mpuugaAbdu/Smart-movable-Dustbin/report.docx

# SMART VOICE CONTROLLED DUSTBIN

# CHAPTER ONE

# INTRODUCTION

## 1.0 Introduction

The advancement of technology has significantly transformed healthcare delivery by introducing intelligent systems that improve efficiency, safety, and convenience in medical environments. Automation, robotics, and artificial intelligence (AI) have become increasingly important in modern healthcare, particularly in reducing manual operations and supporting healthcare professionals during critical procedures.

Surgical theatres are highly sensitive environments where medical personnel must maintain strict hygiene standards, minimize unnecessary movements, and concentrate on patient care. During surgical operations, healthcare professionals generate different types of medical waste, including used gauze, gloves, packaging materials, and other disposable medical supplies. Proper disposal of these materials is essential for maintaining cleanliness and reducing the risk of contamination.

Conventional waste bins are generally positioned at fixed locations within operating theatres. Consequently, medical personnel may need to move toward a waste disposal point or depend on an assistant to bring a waste container closer. Such activities may introduce unnecessary movements and interruptions during surgical procedures.

This project presents the design and development of an offline voice-controlled mobile smart dustbin for surgical theatres, utilizing the AI-Thinker VC-02 offline voice recognition module. The proposed system allows authorized medical personnel to issue predefined voice commands that activate the dustbin's movement, enabling it to approach a designated location for convenient waste disposal.

Unlike conventional voice-controlled systems that depend on internet connectivity or cloud-based speech processing, the proposed system operates offline. This makes it potentially suitable for environments where reliable internet access may not always be available.

The project aims to demonstrate how embedded systems, offline voice recognition, and mobile robotics can be integrated to develop an intelligent waste disposal assistant that supports medical personnel during surgical operations.

## 1.1 Background of the Study

Healthcare facilities continuously seek technological solutions that enhance service delivery, improve operational efficiency, and maintain high standards of hygiene. One area where technological innovation can provide practical assistance is medical waste management.

Medical waste is generated during healthcare activities such as diagnosis, treatment, surgery, and laboratory procedures. In surgical theatres, waste management requires particular attention because of the need to maintain a controlled and hygienic working environment.

Traditionally, waste disposal involves placing waste materials into designated containers positioned at specific locations within the theatre. Although this approach is widely used, it may require healthcare professionals to move away from their immediate working positions or request assistance from other personnel.

Advancements in embedded systems and robotics have created opportunities to automate routine activities. Mobile robotic systems can perform tasks such as transporting materials, delivering supplies, and assisting with logistical operations in healthcare facilities.

Similarly, voice recognition technology enables users to interact with electronic systems through spoken commands. This provides a hands-free control method, which can be beneficial in environments where manual interaction with equipment is inconvenient or undesirable.

The AI-Thinker VC-02 module is an offline voice recognition device capable of recognizing configured voice commands without requiring continuous internet connectivity. When integrated with a microcontroller, motor-driving circuitry, and a mobile platform, the module can serve as a voice-based control interface for a robotic dustbin.

The proposed smart dustbin combines offline voice recognition with robotic mobility to create a system that responds to spoken instructions from medical personnel. For example, a surgeon or theatre assistant could issue a predefined command requesting the dustbin to approach a designated disposal position.

By reducing the need for personnel to move toward a stationary waste container, the system seeks to improve convenience and support smoother workflows within surgical environments.

However, successful application in an actual surgical theatre would require additional considerations, including infection prevention, safe navigation, obstacle detection, appropriate waste containment, and compliance with healthcare safety requirements.

## 1.2 Problem Statement

Surgical operations require healthcare professionals to maintain concentration, minimize unnecessary movements, and follow strict infection prevention procedures. However, conventional waste disposal systems often rely on stationary dustbins, requiring medical personnel to move toward waste collection points or request assistance when disposing of materials.

These manual activities may interrupt workflow, increase unnecessary movement within the operating theatre, and reduce convenience during surgical procedures.

Although automated systems are increasingly being introduced into healthcare environments, many conventional waste bins lack intelligent features such as voice interaction and autonomous or remotely controlled mobility.

Furthermore, some voice-controlled systems depend on internet connectivity, which can limit their reliability in environments with unstable network access.

There is therefore a need to investigate a hands-free, offline voice-controlled mobile waste disposal system that can assist medical personnel by bringing a waste container closer to a designated point when requested.

This project addresses the problem through the development of a prototype smart dustbin using the AI-Thinker VC-02 offline voice recognition module and an embedded motor control system. The proposed solution is intended to demonstrate a convenient approach to waste disposal assistance while minimizing the need for direct physical interaction with the dustbin.

## 1.3 Main Objective

To design and develop an offline voice-controlled mobile smart dustbin that responds to predefined spoken commands and assists medical personnel with convenient waste disposal during surgical procedures.

## 1.4 Specific Objectives

The specific objectives of this project are:

1. To design a mobile smart dustbin capable of responding to predefined voice commands using the AI-Thinker VC-02 offline voice recognition module.
2. To develop an embedded control system that interprets recognized voice commands and controls the movement of the dustbin.
3. To integrate the voice recognition module, microcontroller, motor driver, motors, and power supply into a functional mobile robotic platform.
4. To implement and evaluate hands-free voice control of the dustbin under different operating conditions.
5. To assess the prototype's response time, command recognition reliability, mobility, and potential suitability for assisting waste disposal activities in surgical environments.

## 1.5 Research Questions

This project seeks to answer the following research questions:

1. How can offline voice recognition technology be integrated into a mobile smart dustbin?
2. How effectively can the AI-Thinker VC-02 module recognize predefined voice commands in different environmental conditions?
3. How can a microcontroller-based system control the movement of a dustbin in response to recognized voice commands?
4. What is the response time and reliability of the developed voice-controlled mobile dustbin?
5. To what extent could a voice-controlled mobile dustbin improve convenience and reduce unnecessary movement during surgical waste disposal?

## 1.6 Significance of the Study

The development of an offline voice-controlled mobile smart dustbin has potential benefits in healthcare, engineering education, and technological innovation.

1. Improved convenience for medical personnel

The system is intended to allow healthcare professionals to request a waste container using voice commands instead of physically moving toward a stationary dustbin. This could make routine waste disposal more convenient during surgical procedures.

2. Support for hands-free interaction

Voice recognition provides a method of controlling the dustbin without touching its control interface. This could help reduce unnecessary contact with equipment, although it does not eliminate the need to follow established infection prevention procedures.

3. Reduced dependence on internet connectivity

By using the AI-Thinker VC-02 offline voice recognition module, the system can process configured voice commands without requiring cloud services or continuous internet access.

4. Promotion of healthcare automation

The project demonstrates the potential application of embedded systems, robotics, and voice recognition technology in addressing practical challenges within healthcare environments.

5. Contribution to engineering research and education

The project provides a practical example of integrating voice recognition, microcontroller programming, motor control, and robotic system design. It can serve as a reference for students and researchers developing similar assistive technologies.

6. Potential for further innovation

The prototype could provide a foundation for future developments incorporating obstacle avoidance, intelligent navigation, automatic waste-bin opening, docking systems, and improved safety mechanisms.

## 1.7 Scope of the Study

The scope of this project covers the design, development, integration, and preliminary testing of an offline voice-controlled mobile smart dustbin intended for surgical theatre assistance.

### 1.7.1 Technical Scope

The project focuses on the following areas:

- Implementation of offline voice command recognition using the AI-Thinker VC-02 module.
- Development of a microcontroller-based control system.
- Integration of motors and motor-driving circuitry to enable dustbin movement.
- Development of a mobile platform capable of carrying a waste container.
- Integration of an appropriate power supply for the electronic and electromechanical components.
- Testing of voice command recognition, motor response, and movement control.

### 1.7.2 Functional Scope

The system is intended to recognize predefined voice commands and translate them into appropriate movement instructions.

Its primary function is to enable a user to request or control the movement of the dustbin through spoken instructions.

The level of navigation autonomy depends on the implemented hardware and software. Features such as automatic user localization, obstacle avoidance, and autonomous return to a docking station are not assumed to be present unless separately implemented.

### 1.7.3 Application Scope

The project is primarily intended as a prototype for exploring voice-controlled waste disposal assistance in surgical theatre environments.

Initial testing will focus on demonstrating system functionality under controlled conditions rather than direct deployment during live surgical operations.

Actual clinical deployment would require further evaluation of infection prevention, electrical and mechanical safety, navigation reliability, medical waste segregation, and applicable hospital requirements.

## 1.8 Limitations of the Study

Despite its potential advantages, the proposed system may face several limitations.

1. Background noise

Surgical environments contain equipment and conversations that may interfere with voice command recognition. The performance of the VC-02 module may therefore vary depending on surrounding noise levels.

2. Limited voice command vocabulary

The system relies on predefined commands supported by the offline voice recognition module. It may not understand spoken instructions outside the configured command set.

3. Navigation challenges

The movement of the dustbin may be affected by obstacles, restricted pathways, uneven surfaces, and limited operating space. Without appropriate sensing and navigation features, the system may require controlled operating conditions.

4. Power supply limitations

Because the dustbin is mobile, its operation depends on an onboard power source. Battery capacity and motor power consumption may limit its operating duration.

5. Clinical safety considerations

A mobile robotic dustbin operating near surgical personnel must not interfere with medical equipment, sterile zones, or movement around the patient. Additional safeguards and validation would be required before use in actual operating theatres.

6. Waste handling requirements

Medical waste may contain infectious, sharp, or otherwise hazardous materials. The prototype does not automatically establish compliance with medical waste segregation and disposal standards. Appropriate containment and cleaning procedures would be necessary.

## 1.9 Justification of the Study

The development of an offline voice-controlled mobile smart dustbin is motivated by the need to explore practical technological solutions that can support healthcare professionals during demanding medical procedures.

In surgical theatres, unnecessary movement and interruptions can affect the efficiency of routine activities. A mobile dustbin that responds to spoken commands offers a potentially convenient alternative to conventional stationary waste containers.

The use of offline voice recognition is particularly relevant because it allows the system to function without depending on internet connectivity. This approach may also reduce the complexity associated with cloud-based voice processing.

Additionally, the project demonstrates how relatively accessible electronic components and embedded technologies can be combined to address real-world healthcare challenges.

The study is therefore justified as a prototype development effort that investigates the technical feasibility of voice-controlled mobile waste disposal assistance and establishes a foundation for future improvements and clinical evaluation.

## 1.10 Organization of the Report

This report is organized into five chapters.

Chapter One: Introduction

This chapter presents the background of the study, problem statement, objectives, research questions, significance, scope, limitations, and justification of the project.

Chapter Two: Literature Review

This chapter reviews existing studies and technologies related to smart waste management, healthcare robotics, offline voice recognition, embedded control systems, and mobile robotic platforms.

Chapter Three: Methodology and System Design

This chapter describes the research methodology, hardware components, system architecture, circuit design, software development, and procedures followed during implementation.

Chapter Four: System Implementation, Testing, and Results

This chapter presents the implementation of the developed prototype, testing procedures, observations, performance measurements, and discussion of results.

Chapter Five: Conclusion and Recommendations

This chapter summarizes the project findings, evaluates the achievement of the objectives, identifies remaining challenges, and provides recommendations for future improvements.
