mpuugaAbdu/Smart-movable-Dustbin/images/control details edit.png

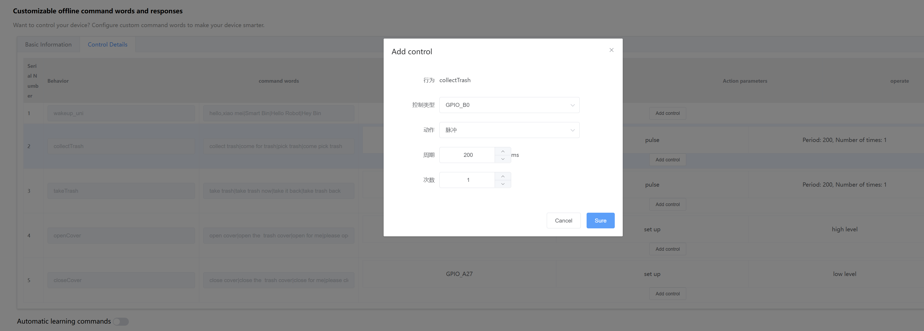
images/control details edit.png
