mpuugaAbdu/Smart-movable-Dustbin/images/perfB.png

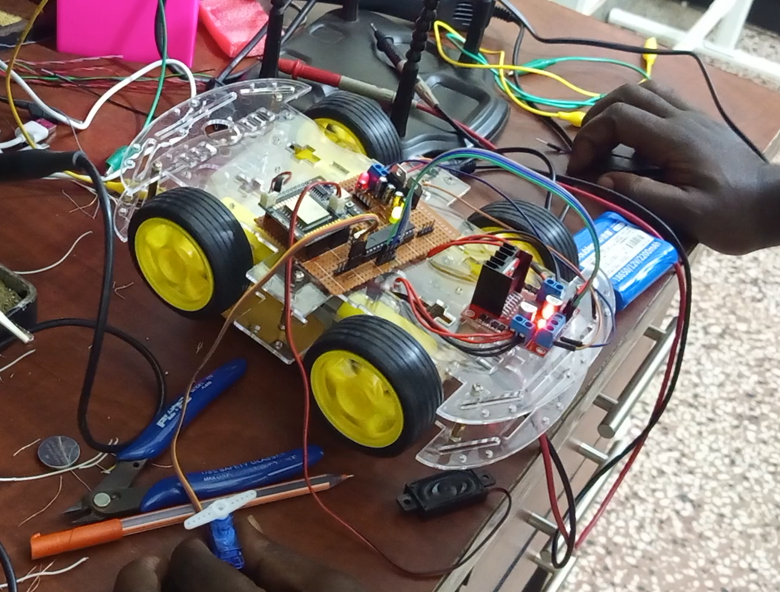
images/perfB.png
