mpuugaAbdu/Smart-movable-Dustbin/images/pin config.png

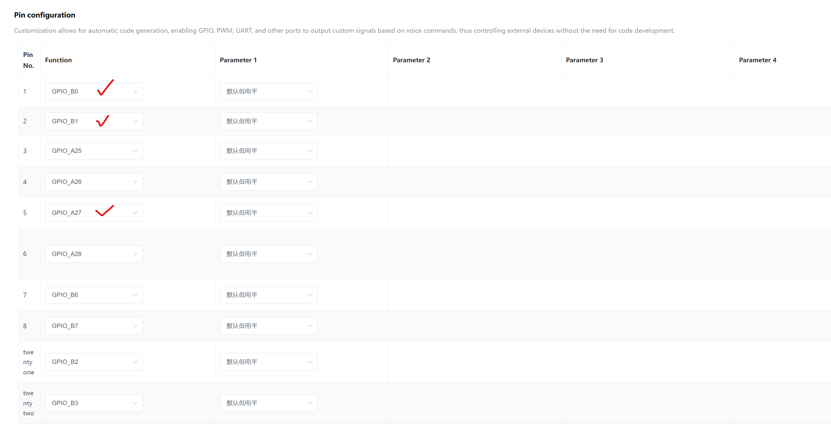
images/pin config.png
