mpuugaAbdu/Smart-movable-Dustbin/images/sdk download.png

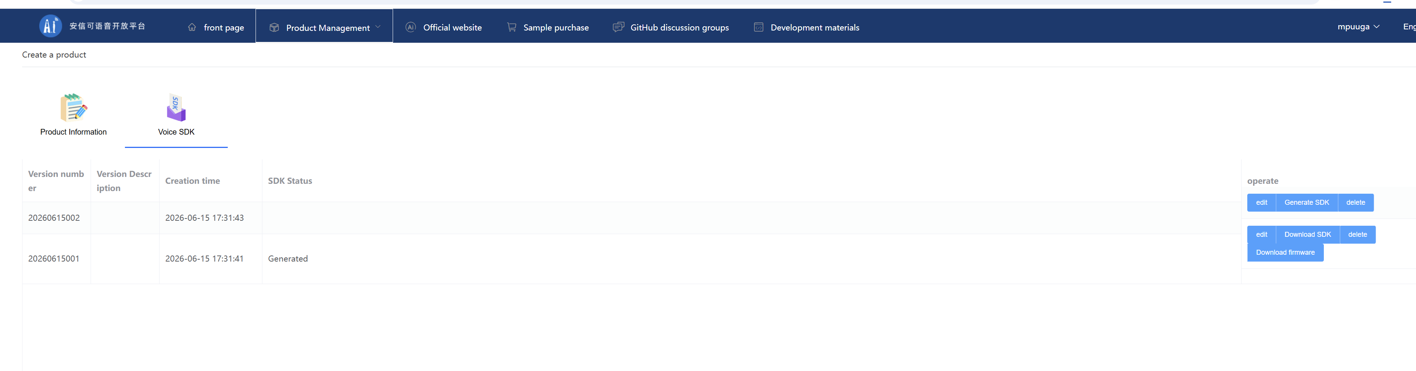
images/sdk download.png
