mpuugaAbdu/Smart-movable-Dustbin/stl files for control circuit casing/robotic_ctrl-PartBody.stl

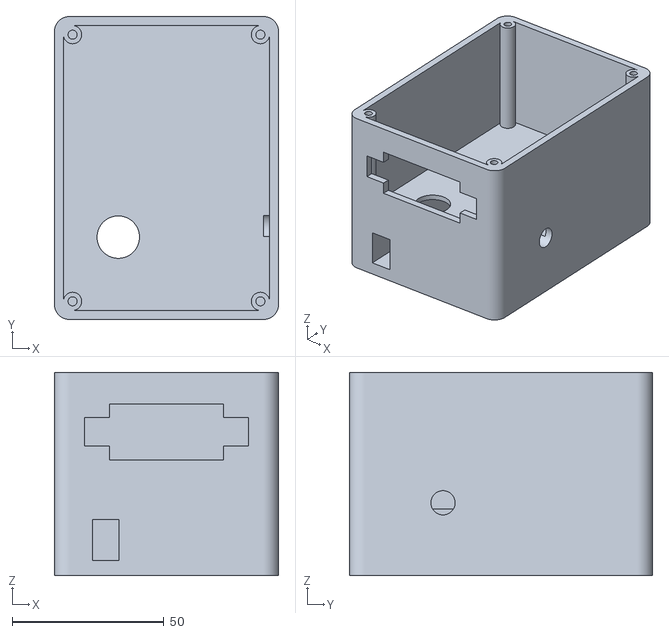
[picture p9: CAD file, 2026-10-16]
stl files for control circuit casing/robotic_ctrl-PartBody.stl
74.0 x 100.0 x 67.0
