mpuugaAbdu/Smart-movable-Dustbin/stl files for control circuit casing/cover_robot-PartBody.stl

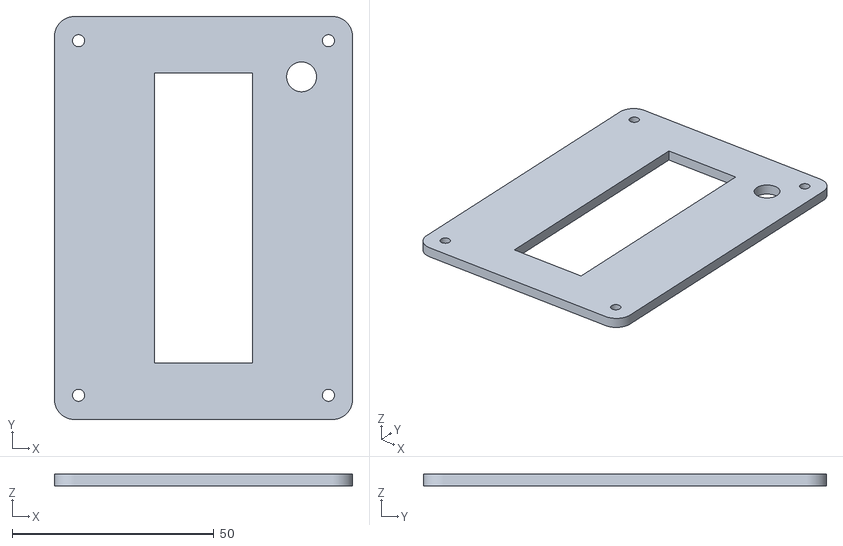
[picture p10: CAD file, 2026-10-16]
stl files for control circuit casing/cover_robot-PartBody.stl
74.0 x 100.0 x 3.00
