mpuugaAbdu/Smart-movable-Dustbin/images/soldered side.jpg

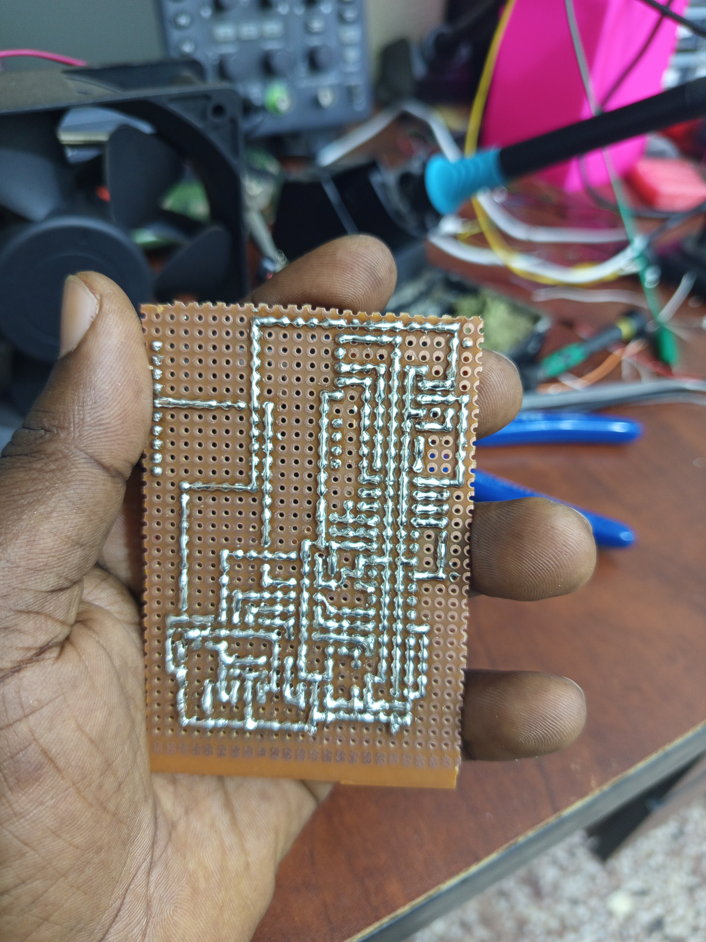
images/soldered side.jpg
